Pablomonte/LibreIncu-150/img/manual/placa-olivia-potencia.png

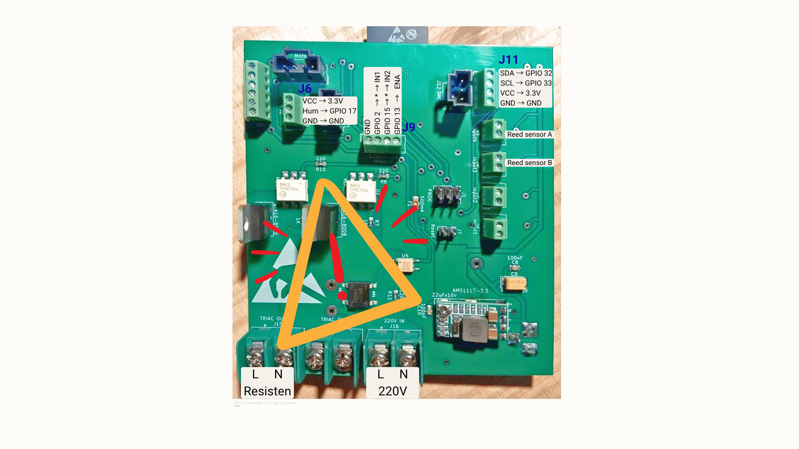
img/manual/placa-olivia-potencia.png
