Pablomonte/LibreIncu-150/img/manual/j9-puente-h.png

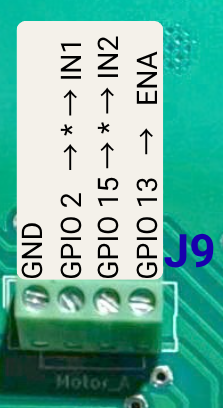
img/manual/j9-puente-h.png
