Pablomonte/LibreIncu-150/img/cad/bandejas-y-soportes.png

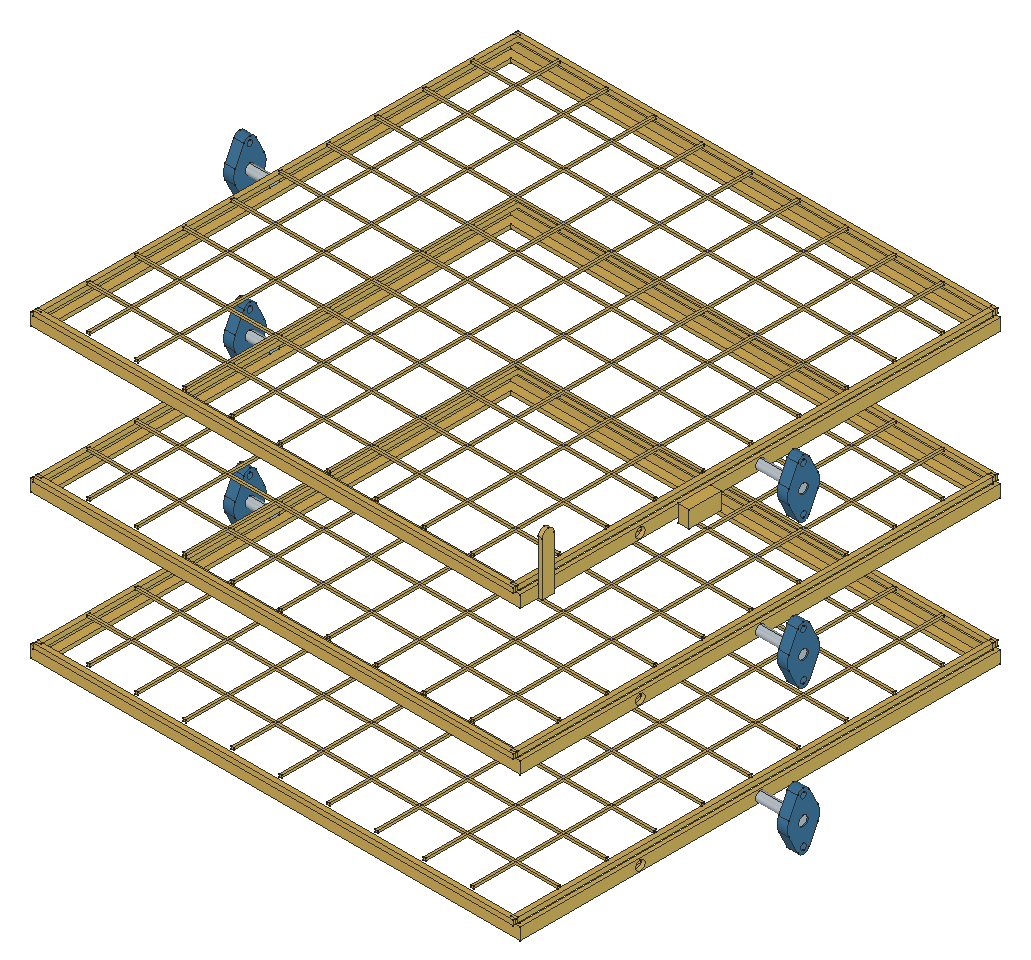
img/cad/bandejas-y-soportes.png
