Pablomonte/LibreIncu-150/img/cad/carro-y-finales-de-carrera.png

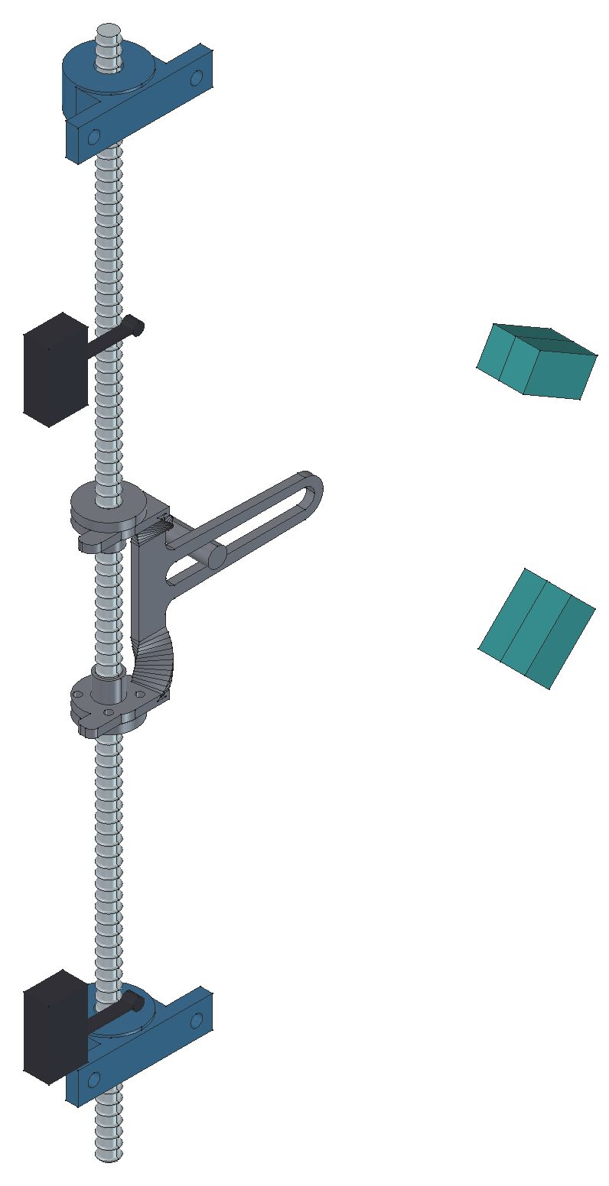
img/cad/carro-y-finales-de-carrera.png
