Pablomonte/LibreIncu-150/img/cad/corte-lateral.png

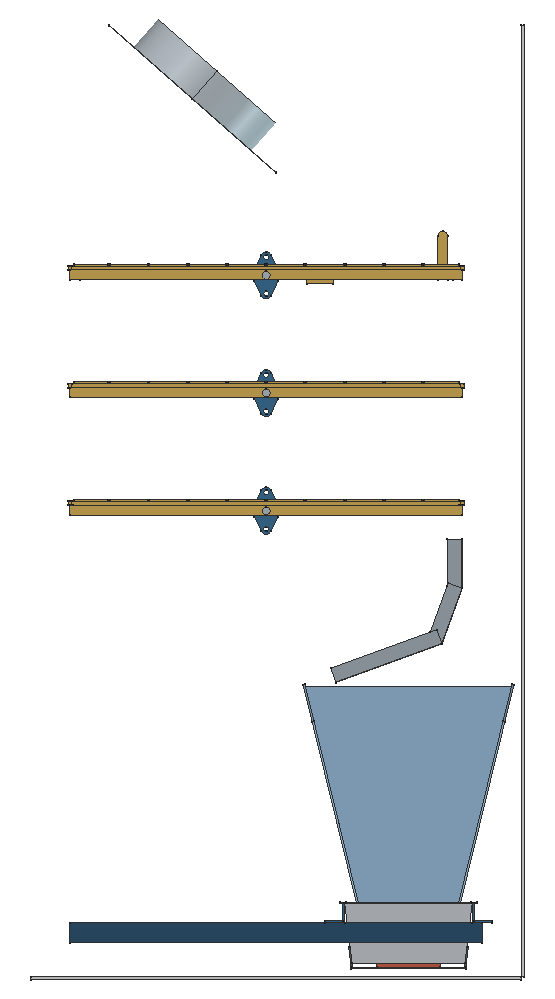
img/cad/corte-lateral.png
