Pablomonte/LibreIncu-150/img/cad/desarrollo-carro.png

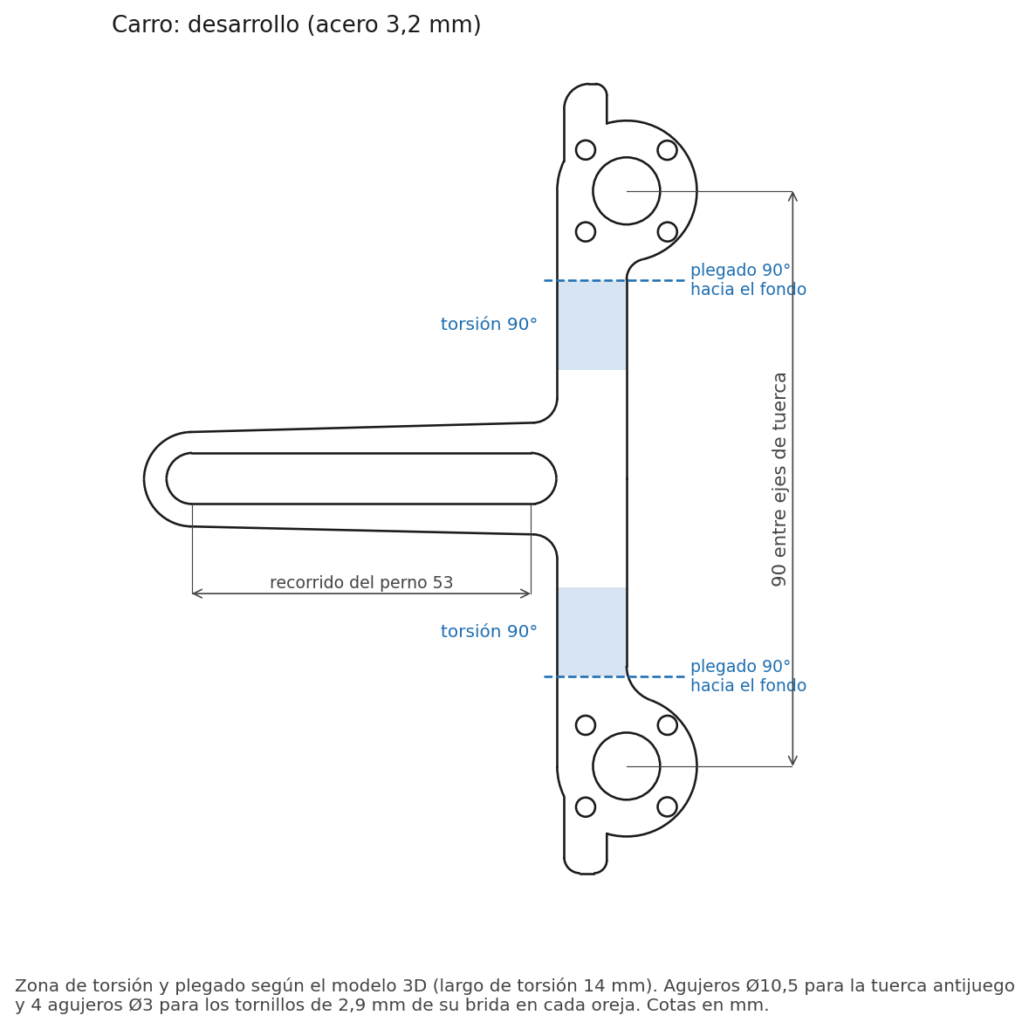
img/cad/desarrollo-carro.png
