Pablomonte/LibreIncu-150/img/cad/desarrollo-contraplaca.png

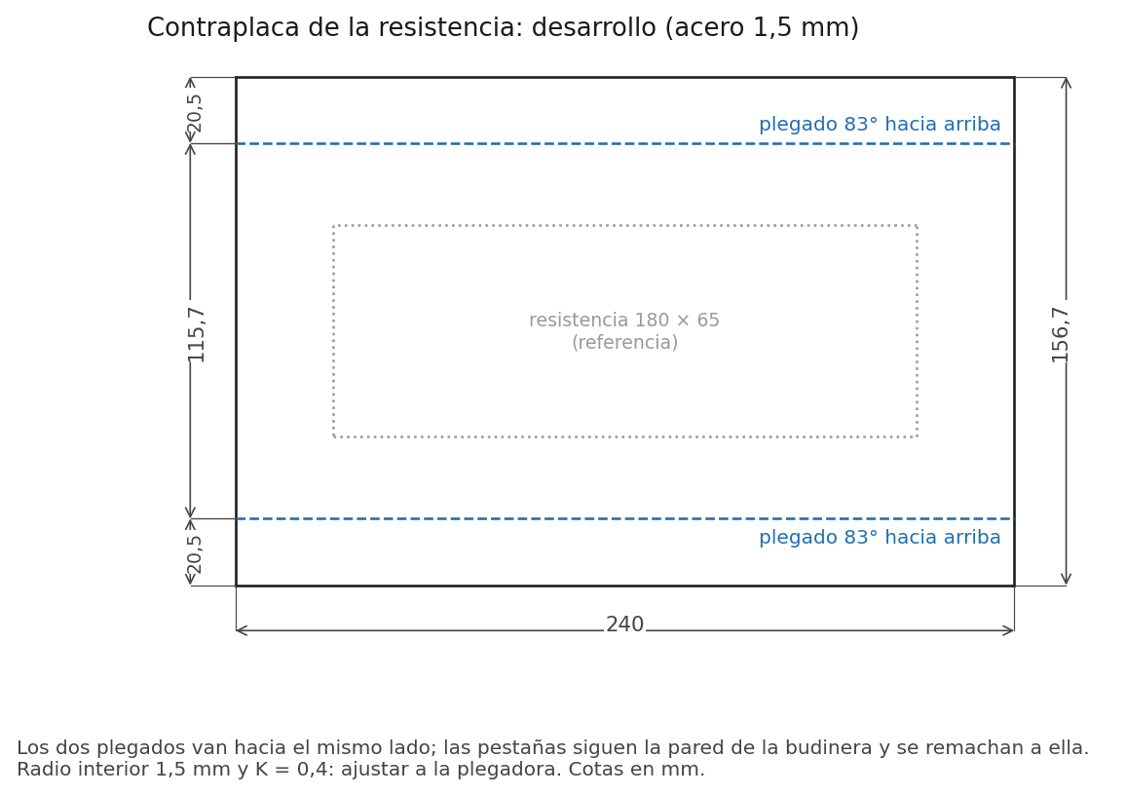
img/cad/desarrollo-contraplaca.png
