Pablomonte/LibreIncu-150/img/cad/desarrollo-deflector.png

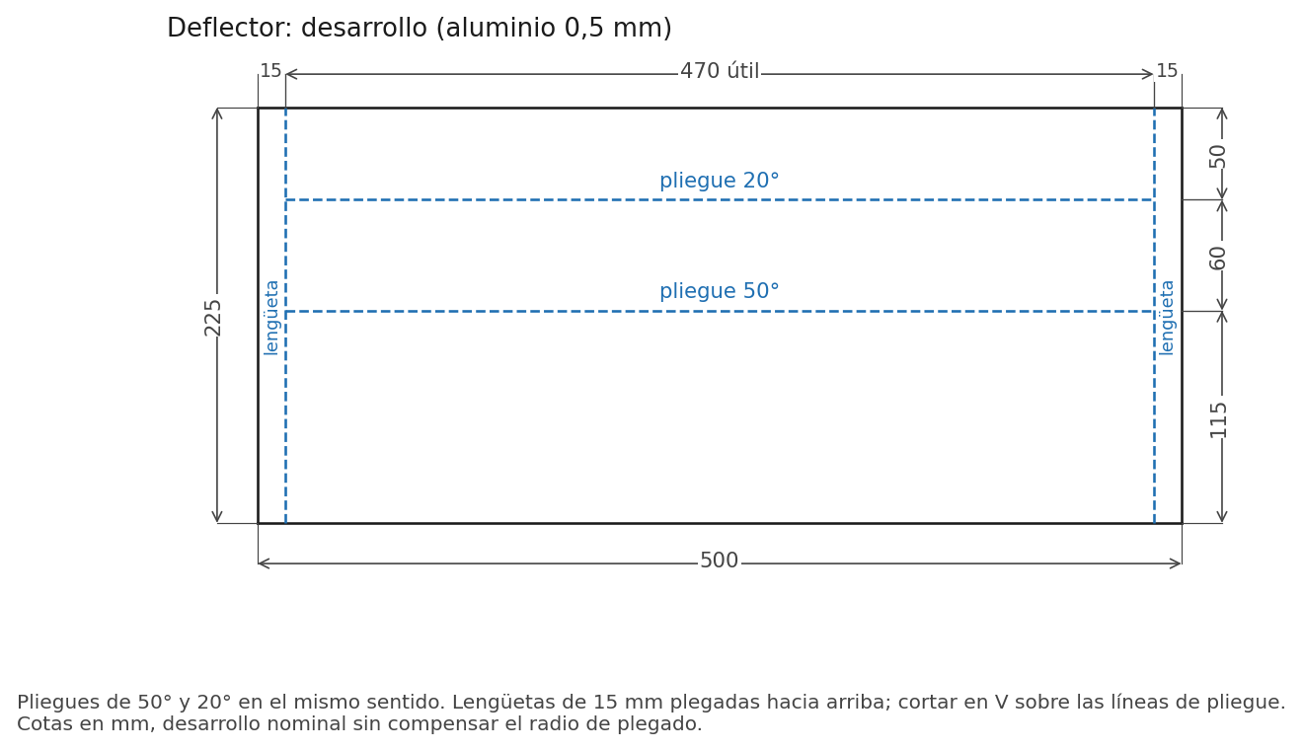
img/cad/desarrollo-deflector.png
