Pablomonte/LibreIncu-150/img/cad/fuente-de-calor-inferior.png

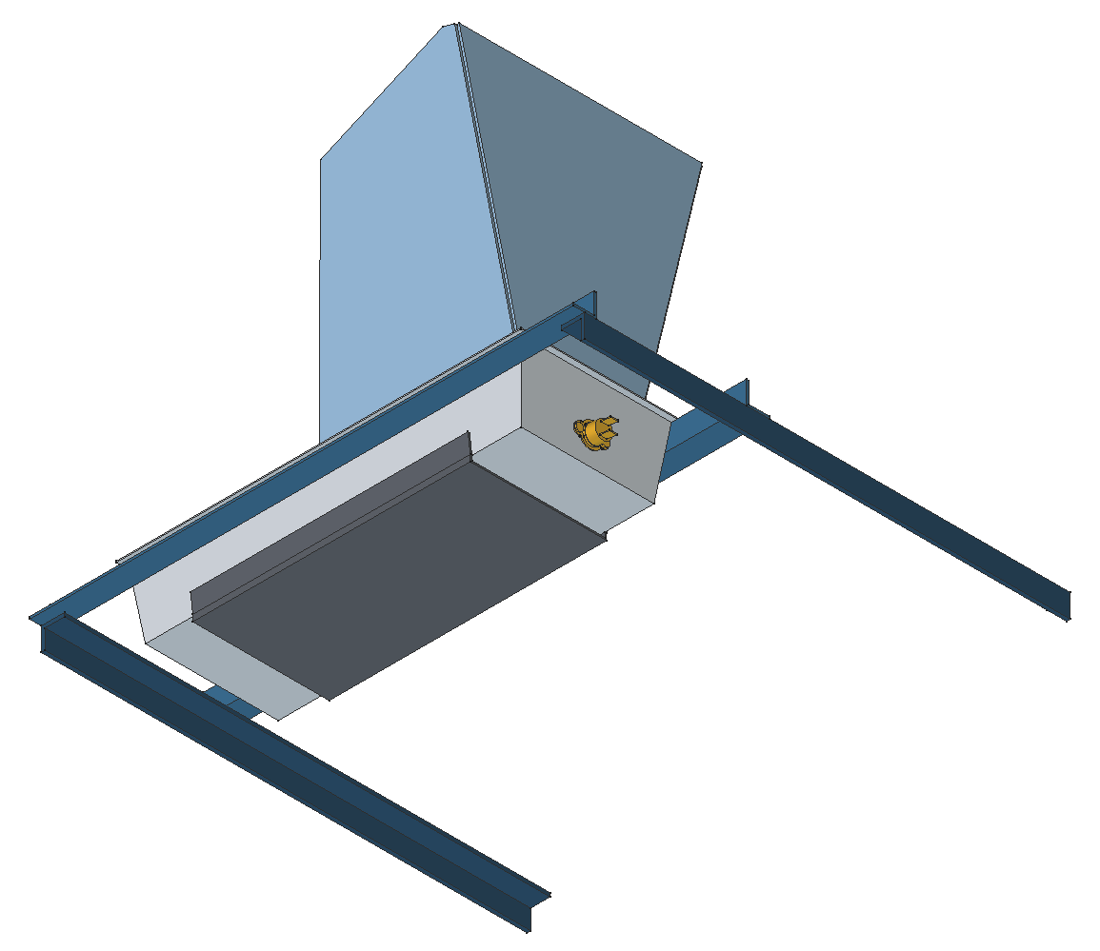
img/cad/fuente-de-calor-inferior.png
