Pablomonte/LibreIncu-150/img/cad/fuente-de-calor.png

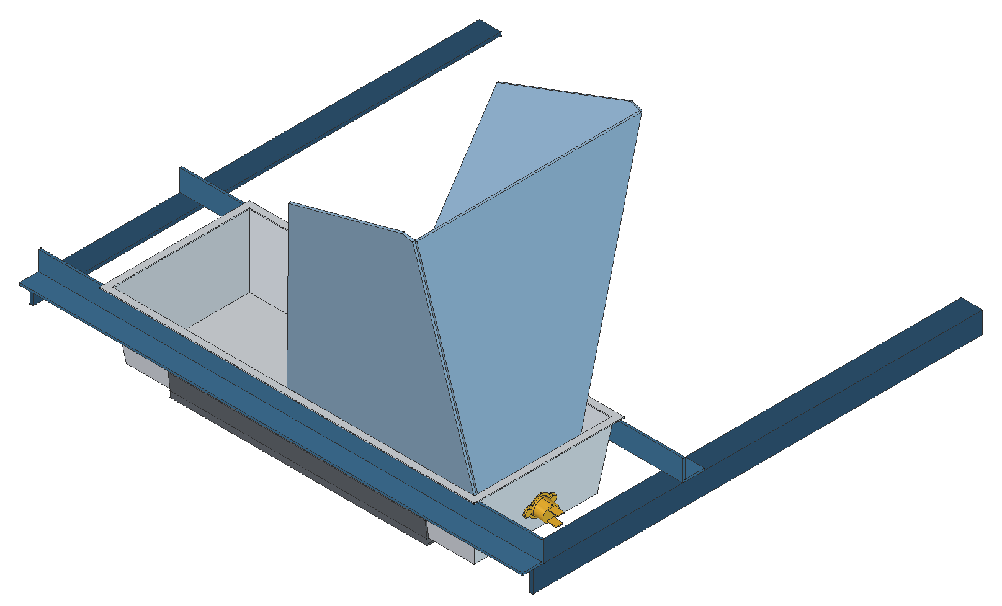
img/cad/fuente-de-calor.png
