Pablomonte/LibreIncu-150/img/cad/husillo-kp08-acople.png

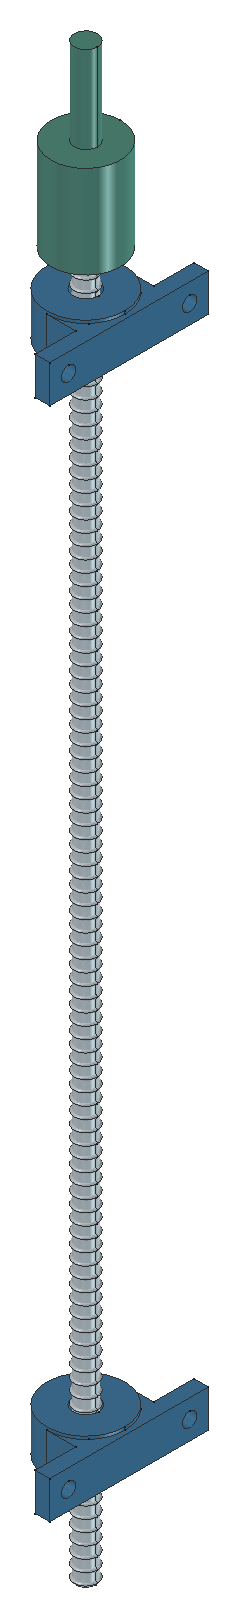
img/cad/husillo-kp08-acople.png
