Pablomonte/LibreIncu-150/img/planos/ALT-INC001-01-01.png

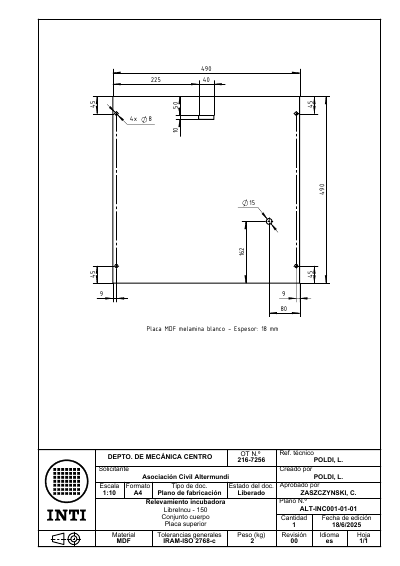
img/planos/ALT-INC001-01-01.png
