Pablomonte/LibreIncu-150/img/planos/ALT-INC001-01-05.png

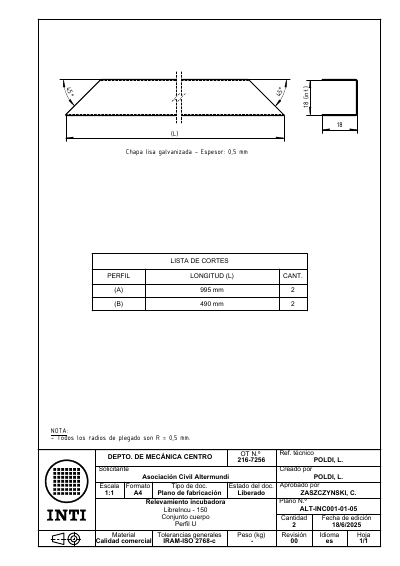
img/planos/ALT-INC001-01-05.png
