Pablomonte/LibreIncu-150/img/planos/ALT-INC001-03-00.png

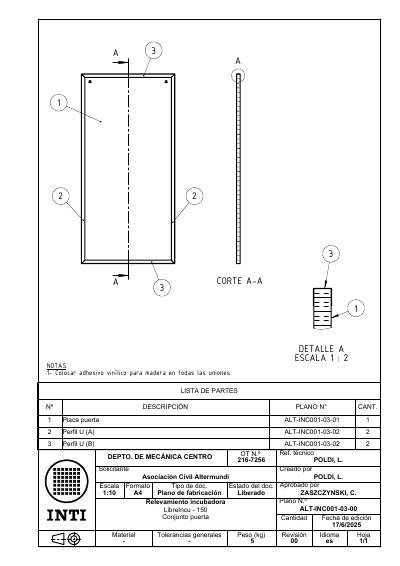
img/planos/ALT-INC001-03-00.png
