Pablomonte/LibreIncu-150/img/planos/ALT-INC001-03-02.png

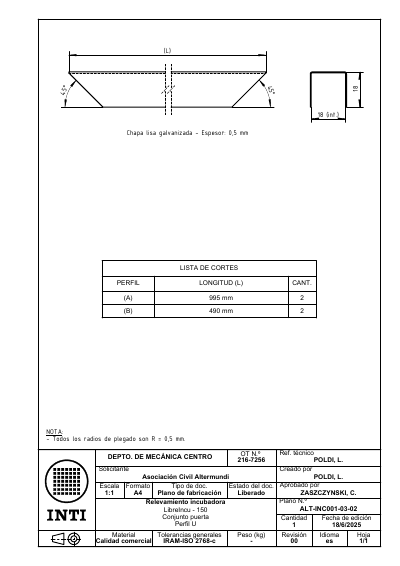
img/planos/ALT-INC001-03-02.png
