Pablomonte/LibreIncu-150/img/planos/ALT-INC001-09-00.png

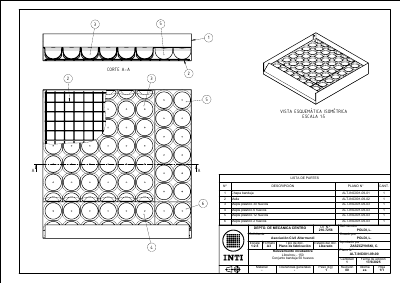
img/planos/ALT-INC001-09-00.png
