Pablomonte/LibreIncu-150/img/planos/ALT-INC001-11-00.png

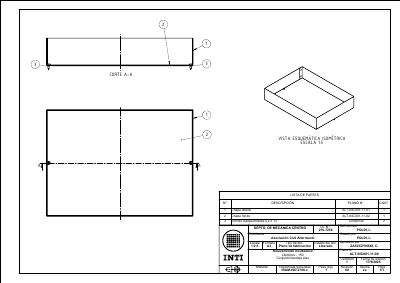
img/planos/ALT-INC001-11-00.png
