Pablomonte/LibreIncu-150/img/planos/ALT-INC001-11-01.png

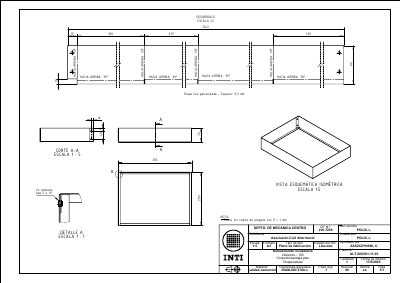
img/planos/ALT-INC001-11-01.png
