Pablomonte/LibreIncu-150/img/planos/ALT-INC001-11-02.png

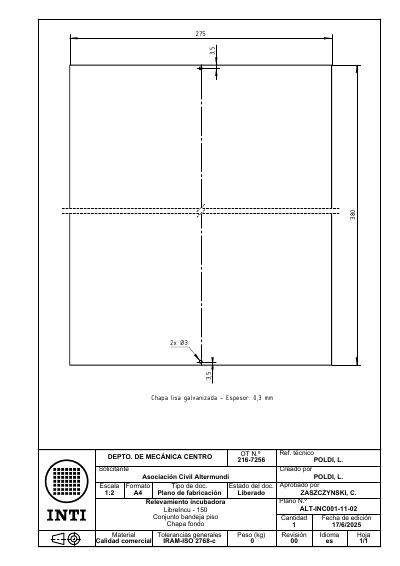
img/planos/ALT-INC001-11-02.png
