Pablomonte/LibreIncu-150/img/planos/ALT-INC001-12-00.png

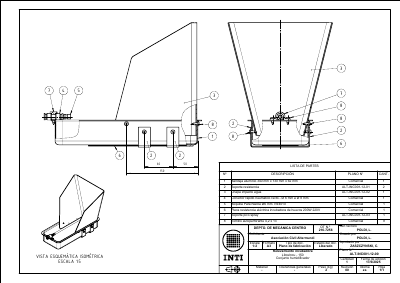
img/planos/ALT-INC001-12-00.png
