Pablomonte/LibreIncu-150/cad/carro-y-finales-de-carrera.step

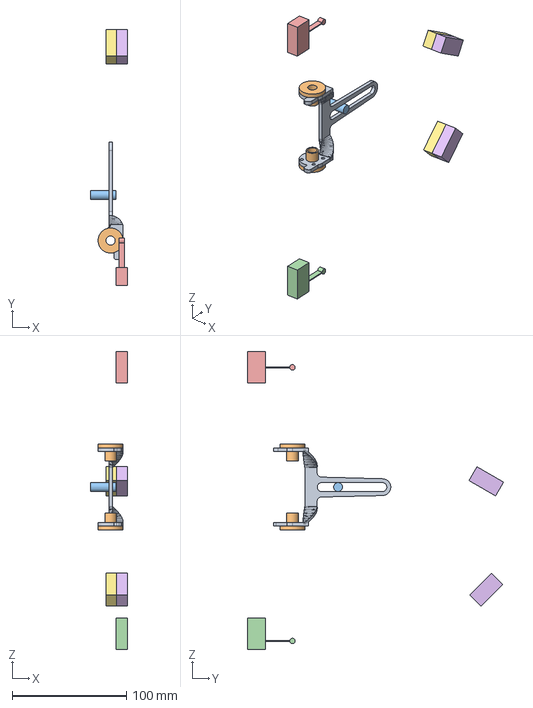
[picture p35: CAD file, 2026-11-13]
cad/carro-y-finales-de-carrera.step
32.8 x 224.7 x 261.4 mm
