Pablomonte/LibreIncu-150/cad/husillo-kp08-acople.step

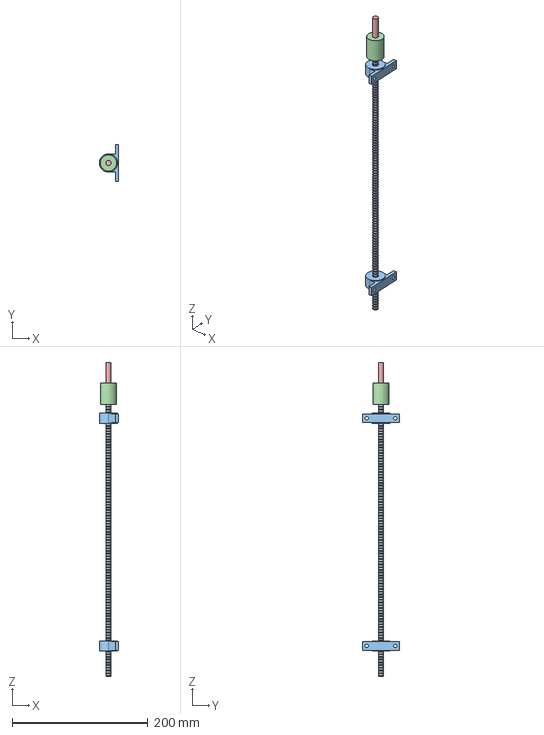
[picture p36: CAD file, 2026-11-13]
cad/husillo-kp08-acople.step
28.5 x 55.0 x 462.0 mm
