Pablomonte/LibreIncu-150/cad/deflector.step

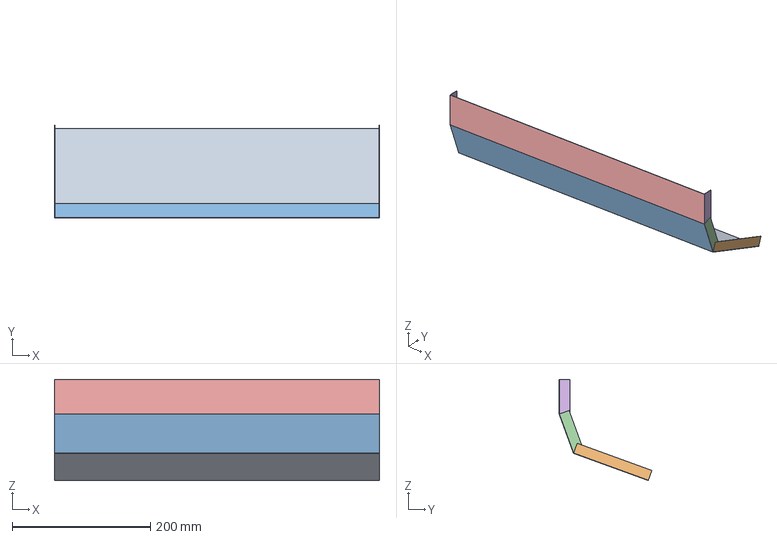
[picture p37: CAD file, 2026-11-13]
cad/deflector.step
470.0 x 134.2 x 146.2 mm
