Pablomonte/LibreIncu-150/cad/Deflector_Aire.dxf

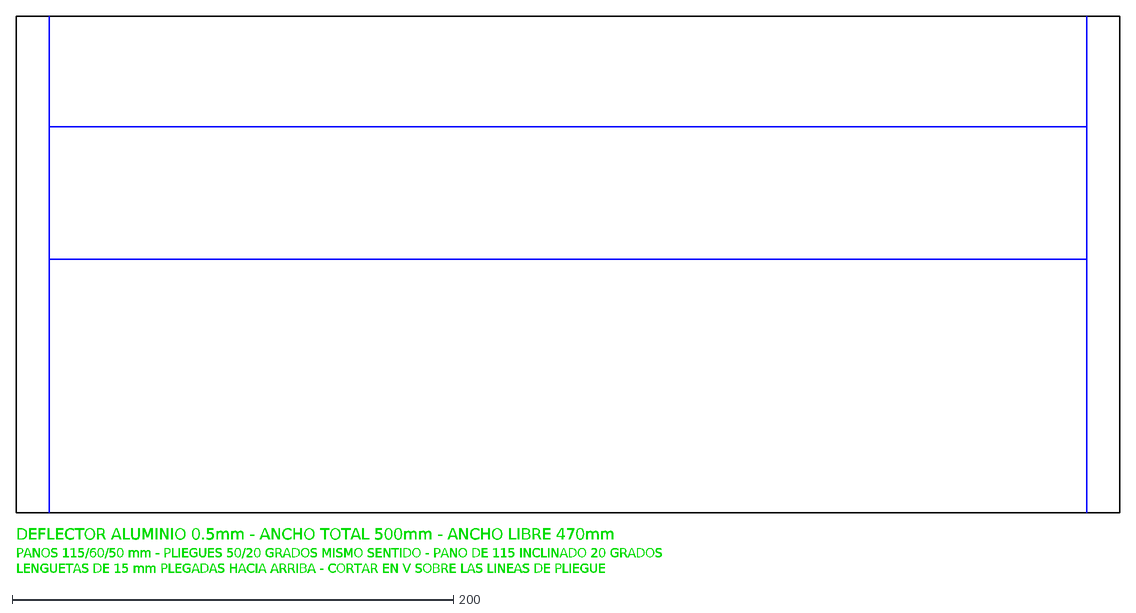
[picture p38: CAD file, 2026-11-13]
cad/Deflector_Aire.dxf
DEFLECTOR ALUMINIO 0.5mm - ANCHO TOTAL 500mm - ANCHO LIBRE 470mm
PANOS 115/60/50 mm - PLIEGUES 50/20 GRADOS MISMO SENTIDO - PANO DE 115 INCLINADO 20 GRADOS
LENGUETAS DE 15 mm PLEGADAS HACIA ARRIBA - CORTAR EN V SOBRE LAS LINEAS DE PLIEGUE
