Pablomonte/LibreIncu-150/cad/contraplaca_desarrollo.dxf

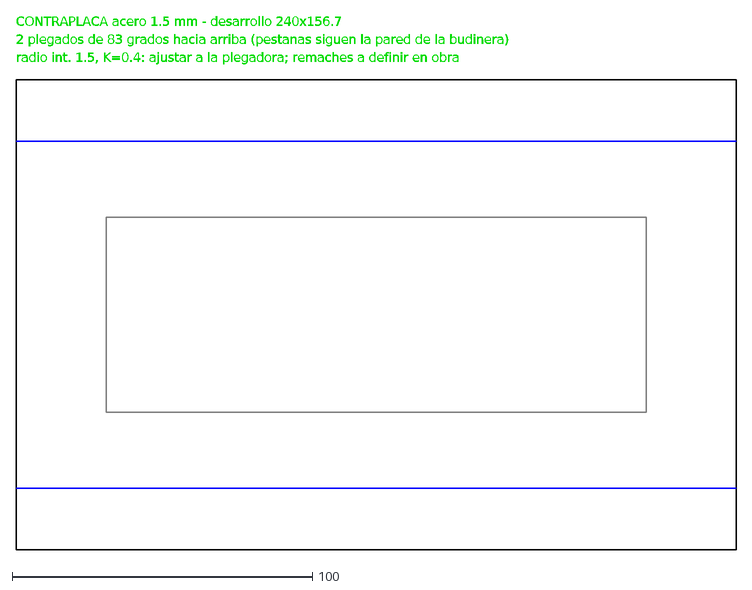
[picture p39: CAD file, 2026-11-13]
cad/contraplaca_desarrollo.dxf
CONTRAPLACA acero 1.5 mm - desarrollo 240x156.7
2 plegados de 83 grados hacia arriba (pestanas siguen la pared de la budinera)
radio int. 1.5, K=0.4: ajustar a la plegadora; remaches a definir en obra
