Pablomonte/LibreIncu-150/cad/LibreIncu_Rediseno_Despiece.step

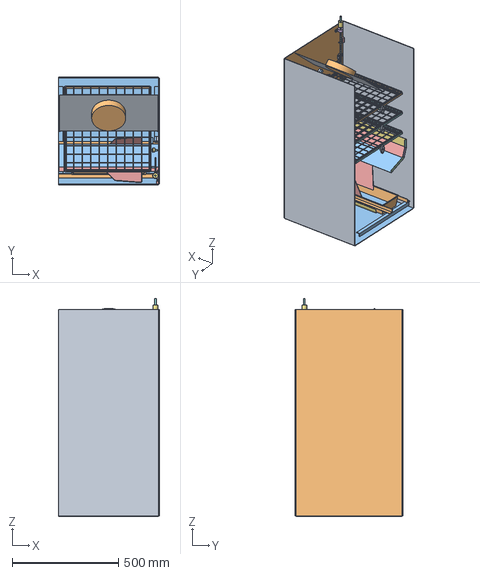
[picture p40: CAD file, 2026-11-13]
cad/LibreIncu_Rediseno_Despiece.step
473.0 x 506.0 x 1025.0 mm
