Pablomonte/LibreIncu-150/cad/chapa_ranurada_bandeja.dxf

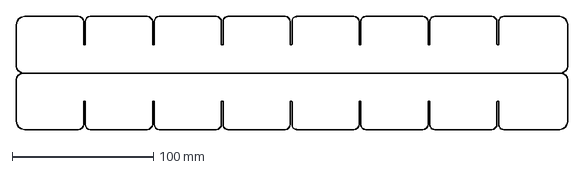
[picture p41: CAD file, 2026-11-13]
cad/chapa_ranurada_bandeja.dxf
390.0 x 80.0 mm
