Pablomonte/LibreIncu-150/cad/carro_portatuercas_corredera-Body.dxf

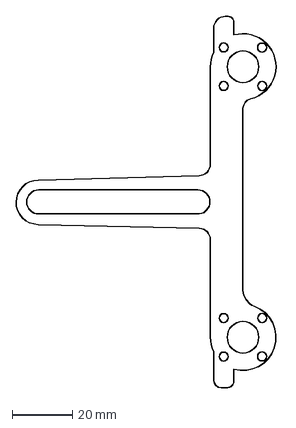
[picture p42: CAD file, 2026-11-13]
cad/carro_portatuercas_corredera-Body.dxf
87.8 x 123.5 mm
