Pablomonte/LibreIncu-150/cad/fuente-de-calor.step

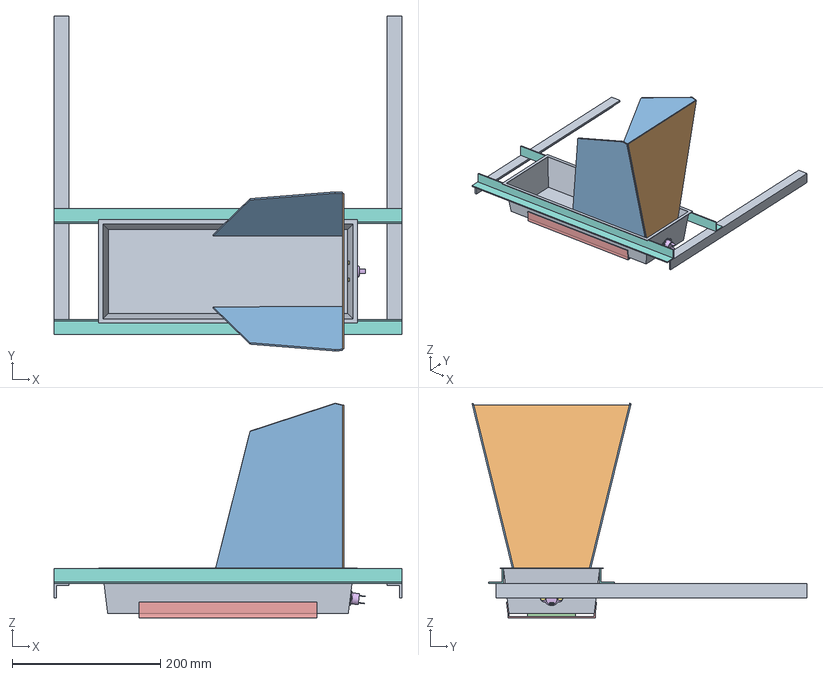
[picture p43: CAD file, 2026-11-13]
cad/fuente-de-calor.step
470.0 x 452.5 x 289.8 mm
