Pablomonte/LibreIncu-150/cad/bandejas-y-soportes.step

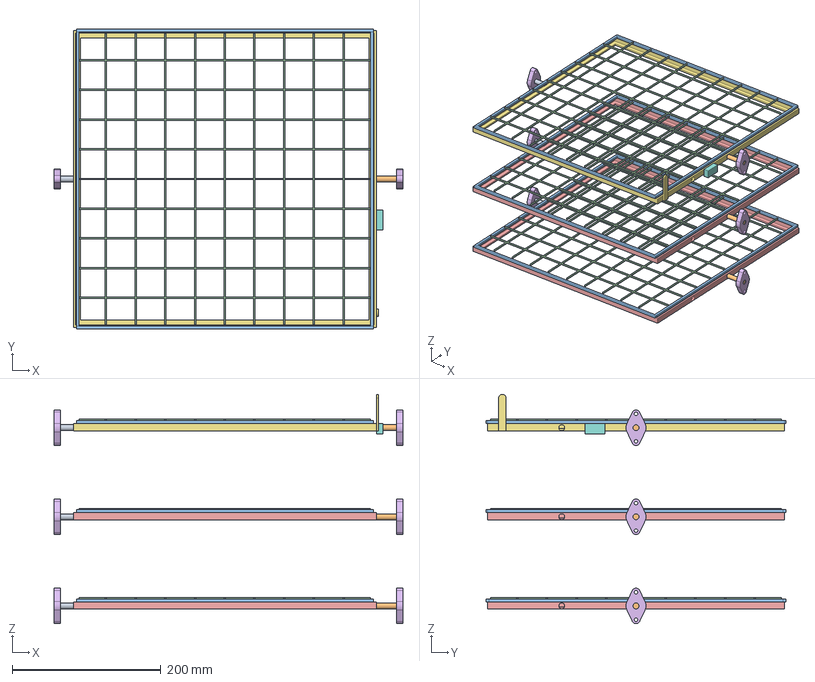
[picture p44: CAD file, 2026-11-13]
cad/bandejas-y-soportes.step
470.0 x 404.0 x 309.0 mm
