Pablomonte/LibreIncu-150/img/manual/deflector-chapa-impacto-agua.jpg

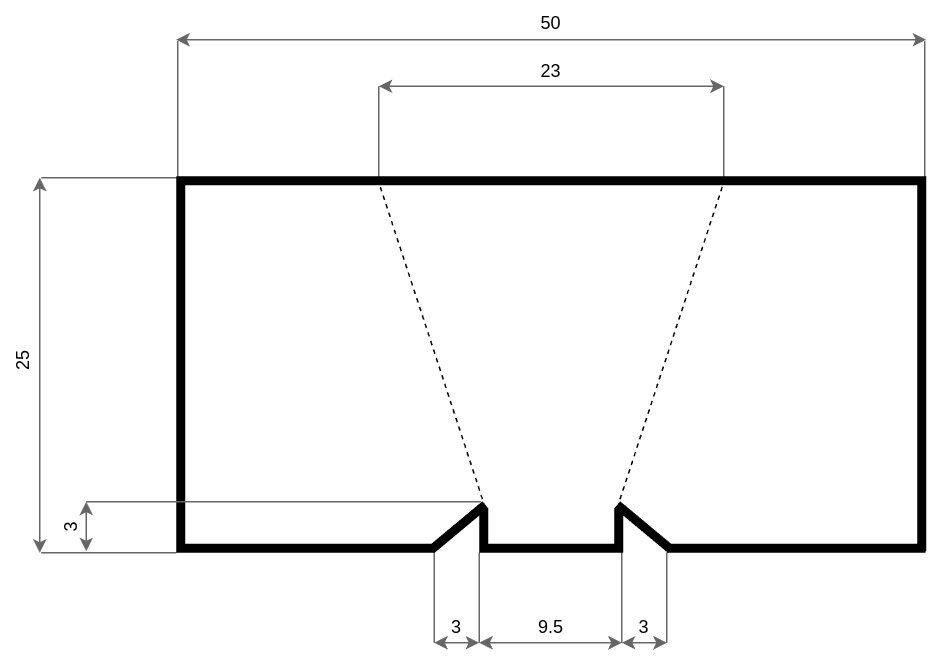
img/manual/deflector-chapa-impacto-agua.jpg
