Pablomonte/LibreIncu-150/img/manual/deflector-chapa.png

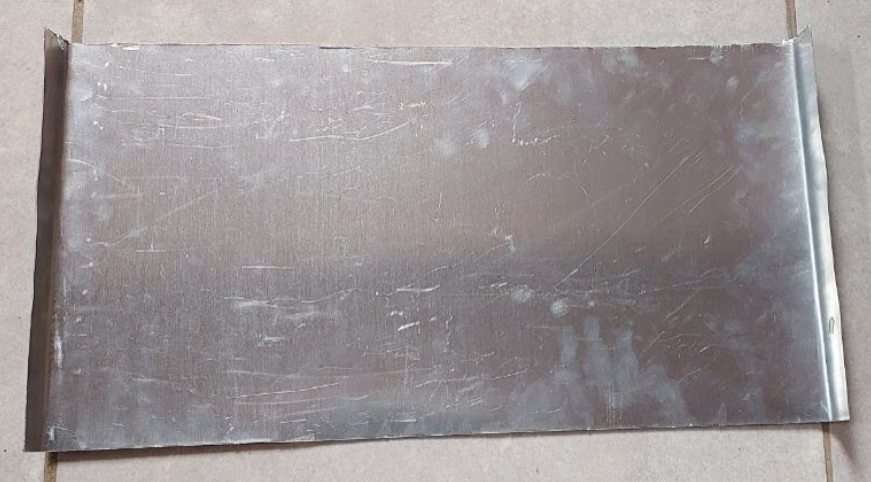
img/manual/deflector-chapa.png
