Pablomonte/LibreIncu-150/img/manual/deflector-plegado.png

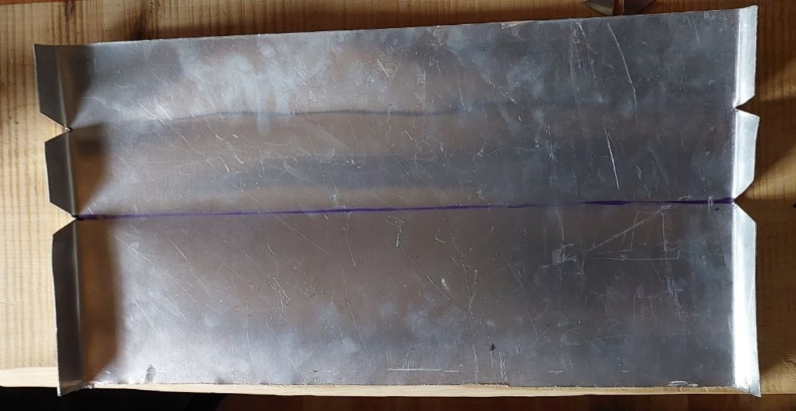
img/manual/deflector-plegado.png
