Pablomonte/LibreIncu-150/img/manual/j6-humidificador.png

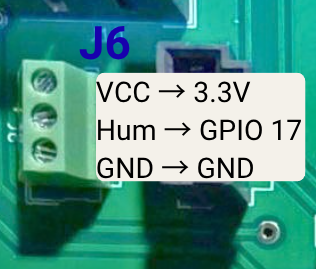
img/manual/j6-humidificador.png
