Pablomonte/LibreIncu-150/img/manual/modulo-reles.png

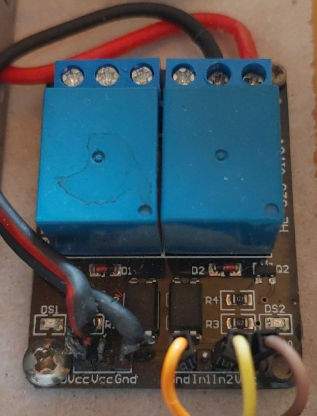
img/manual/modulo-reles.png
