Pablomonte/LibreIncu-150/img/manual/step-down.png

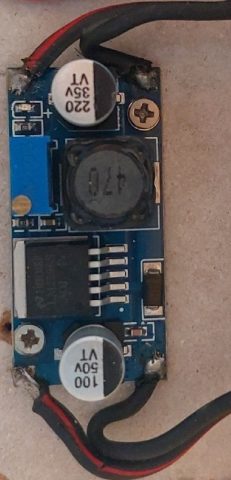
img/manual/step-down.png
